tekkies/esp-12e-mqtt-onewire-temperature-sensor/board/ESP-12E-OneWire-FRONT-VeeCAD.pdf

D

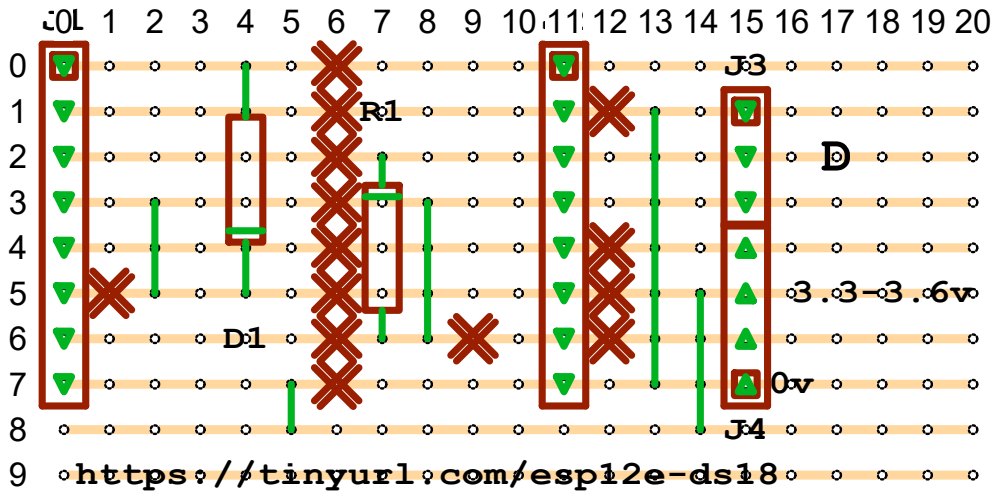
[picture p6: page 1]
https://tinyurl.com/esp12e-ds18
