tekkies/esp-12e-mqtt-onewire-temperature-sensor/board/ESP-12E-OneWire-REAR-VeeCAD.pdf

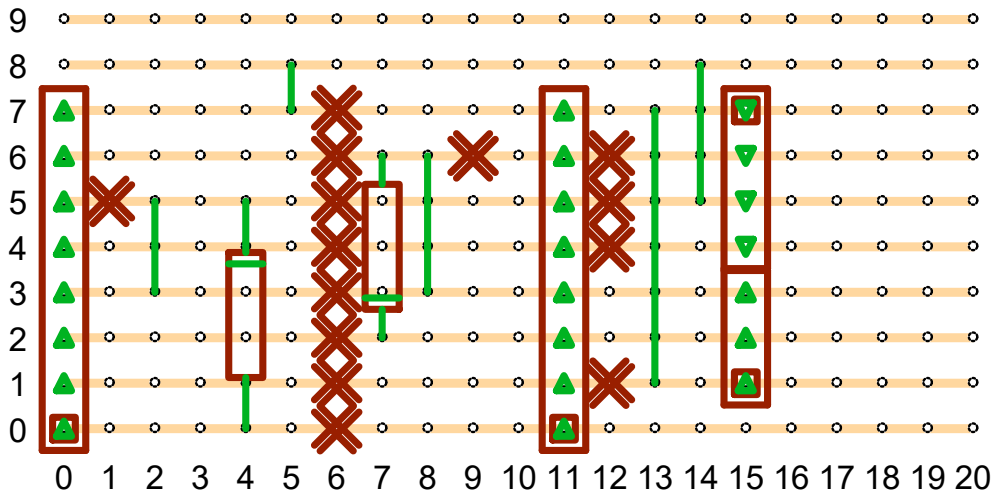
[picture p7: page 1]
