tekkies/esp-12e-mqtt-onewire-temperature-sensor/(list of files, drawings)

Other design files:
board/ESP-12E-OneWire-TinyCAD.dsn
