tekkies/esp-12e-mqtt-onewire-temperature-sensor/(commit log)

2022-02-20 ESP-12E and Power connector added
    [ESP-12E-OneWire-TinyCAD.dsn]
2022-02-20 Initial Circuit Diagram
    [ESP-12E-OneWire-TinyCAD.dsn]
2022-02-20 Use DIL module graphic
    [ESP-12E-OneWire-TinyCAD.dsn]
2022-02-20 Compact board layout
2022-02-23 Added OneWire example and powered the BUS on GPIO4
2022-02-23 MILESTONE: Read the temperature from a DS18S20
2022-02-24 Connect WAKE to RESET for deep sleep support
    WAKE pin AKA GPIO16
    [ESP-12E-OneWire-TinyCAD.dsn]
2022-02-24 Add arduino-mqtt submodule
2022-02-24 Test MQTT sample
2022-02-24 Circuit: Use a diode for wake
    Allows USB IC to reset board still
    [ESP-12E-OneWire-TinyCAD.dsn]
2022-02-24 Layout: Use a diode for wake
    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
2022-02-24 Pick 1N4007 as the diode
    [ESP-12E-OneWire-TinyCAD.dsn]
2022-02-24 Switch between states on each loop
2022-02-25 Power the OneWire bus
2022-02-25 Found a device on the bus
2022-02-25 Success and Fail states
    [esp-12e-mqtt-onewire-temperature-sensor.ino, oneWireStateMachine.cpp, oneWireStateMachine.h, stateMachine.h]
2022-02-25 Identify the OneWire device
2022-02-26 Failed attempt at exit state checking
    [stateMachine.cpp, stateMachine.h]
2022-02-26 Successfully read 1 temperature
2022-02-26 TEST: Poll sensor while waiting
2022-02-26 Poll for conversion compete instead of waiting a fixed time
    [esp-12e-mqtt-onewire-temperature-sensor.ino, oneWireStateMachine.cpp, oneWireStateMachine.h]
2022-02-26 MILESTONE: Read multiple OneWire devices
2022-02-26 Remove some prints
2022-02-26 MILESTONE: Published a random string after reading temperature
2022-03-06 Include sensor model in MQTT
